mauro-hw/sky130-flash-adc-layout/(commit log)

2026-10-28 Start the SKY130 comparator layout project
    The comparator of the 3-bit flash ADC, as the pre-layout reference for LVS: every
    device is now a SKY130 device, with the 1.3 Mohm bias resistor as a high-resistivity
    poly resistor (0.35 x 227.5 um). Apache 2.0 with a NOTICE, so that reuse keeps the
    author's name.
2026-10-28 Credit the circuit to Claude and record its offset with mismatch
    The comparator was written by Claude in a development session, not designed by a
    VibeSPICE agent, so the README and NOTICE now say so. With the PDK's mismatch models
    (tt_mm, 30 runs) its offset has a 22.8 mV standard deviation against a +-8.16 mV
    requirement: the input pair and the mirror are too small, which the layout cannot fix.
2026-10-29 The comparator to lay out, verified before layout
    A VibeSPICE session (Claude Code as its agent) redesigned the comparator for a
    random offset of at most 8 mV, which the ADC's yield asks for. A review then
    found that its mismatch was overstated (m= without mult=) and that its
    regular-Vt pair left the tail source without headroom at the top tap, so the
    pair became low-Vt: sigma 5.2 mV over 112 copies in three corners, and 1.87 uA
    in the tail at 0.79 V in ss.
    scripts/sim.py measures the offset with mismatch, the offset at each tap, the
    current and the output levels; it will run the extracted netlist too. The
    README tells how the design got here and the layout plan.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
2026-10-29 The physical verification flow: DRC, LVS, extraction and GDS
    scripts/flow.py runs Magic without a window for DRC, the extraction (for LVS, and
    flat with parasitic capacitances for simulation) and the GDS, and Netgen for LVS;
    its self-test checks the tools on a transistor from the PDK's generator. sim.py
    now wires the comparator by pin name, so it can run an extracted netlist whose
    pins come in another order.
    mag/.magicrc carries a fix for Fedora 44, whose Magic runs on Tcl 9: the PDK's
    device generators read $sky130::ruleset from inside the namespace sky130, which
    Tcl 9 no longer resolves, and every generated device failed.
2026-10-29 Flow: LVS and the extracted netlist work; the mirror exercise
    With Netgen 1.5 the self-test now passes end to end: no DRC errors, LVS matches
    uniquely, and the extracted transistor draws the same current in ngspice as the
    schematic's (24.46 uA). The flat extraction needed "ext2spice subcircuit top on"
    to keep its .subckt.
    netlist/mirror.spice is the reference for the first layout exercise, the
    comparator's NMOS mirror in a row D A B B A D with its dummies; Netgen matches a
    row of separate units against it.
2026-10-29 Magic on Tcl 9: fix the device dialog too
    Devices 1 -> nmos failed with "can't set magic::w_val: parent namespace doesn't
    exist": Magic's toolkit.tcl sets magic::${pname}_val from inside the namespace
    magic, which Tcl 9 reads as ::magic::magic::w_val, while the dialog's fields use
    ::magic::w_val. .magicrc now redefines the seven procedures that do it with the
    absolute name, which means the same in Tcl 8 and 9.
2026-10-29 Mirror exercise: one 6-finger device, D B A A B D
    Placing six separate units with their guard rings is a fight with Magic's mouse
    for a first layout. The exercise is now one 6-finger device from the generator,
    with its guard ring, whose diffusion strips are routed to their nets. With
    shared diffusion a dummy touches a signal net, so the order is D B A A B D: the
    dummies share the diode's node, in, of low impedance, rather than out. Netgen
    matches that routing against this reference.
2026-10-29 flow.py: the LVS reference as an absolute path
    Netgen runs in the build folder, so a relative reference netlist was not found.
2026-10-29 Mirror: the first layout, DRC and LVS clean
    The comparator's NMOS mirror load as one 6-finger low-Vt device in the order
    D B A A B D, routed in Magic: the vss strips down in metal2 to a bus under the
    guard ring, the gates G1-G4 joined by a metal1 bar with the diode's columns
    brought to it in metal2, and out up the middle column. No DRC errors, and LVS
    matches netlist/mirror.spice uniquely.
2026-10-30 Input pair: a 2 x 4 common centroid, DRC and LVS clean
    The comparator's PMOS input pair as one low-Vt device of two rows of six
    fingers in one n-well with its guard ring, top row D A B B A D and bottom
    row D B A A B D. Columns and gates rise or fall in metal2 to metal1 buses
    above and below the array; TAIL crosses it at the columns it has in both
    rows, and the other four nets cross over the dummies, so no metal passes
    over a real finger's channel. Each drain carries two dummies. No DRC
    errors, and LVS matches netlist/pair.spice uniquely.
    The diary gains how to read a layout and the pair, and a trap: Magic's
    writeall force rewrote an unexpanded transistor at half its resolution.
    Co-Authored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
2026-10-30 Diary: how the comparator decides
    The chain from the inputs to out, block by block; why each stage acts
    like an inverter rather than a divider, with the gain measured in tt;
    and why XM6 does not need to turn off for out to rise.
2026-10-30 Second stage: XM6 as one 2-finger device, DRC and LVS clean
    XM6's errors reach the input divided by the first stage's gain, so it
    gets no common centroid and no dummies: two fingers of the mirror's unit
    in a guard ring, with out on the shared middle column (half the junction
    of two outer ones). OUT1 enters on a metal1 bar over the top gate
    contacts and out leaves downwards in metal2, on the opposite side. No DRC
    errors, and LVS matches netlist/stage2.spice uniquely.
    pair.mag only lost its timestamp and Magic's pending-DRC note when it was
    saved again.
2026-10-30 Bias mirror: one row D 8 5 5 7 7 5 5 8 D, DRC and LVS clean
    The PMOS bias mirror (XM8, XM5, XM7) as one low-Vt device of ten fingers
    in a guard ring. Its errors change the currents by a few per cent but
    hardly the offset, so it needs no more than a symmetric row. With shared
    diffusion only two symmetric orders work; this one gives out a single
    shared column and lets the dummies touch VBIAS, a DC node. VBIAS and vdd
    leave on top, TAIL and out at the bottom. No DRC errors, and LVS matches
    netlist/bias.spice uniquely.
    stage2.mag and its transistor only lost their timestamps and Magic's
    pending-DRC notes when they were saved again.
2026-10-30 Bias resistor: four strips as a serpentine, DRC and LVS clean
    The bias resistor as four high-resistivity poly strips joined in esses in
    metal1, so every link is short and both ends leave on the same side. Its
    value sets the currents but not the offset, so it has no dummies. No DRC
    errors, and LVS matches netlist/rbias.spice uniquely.
    The README's layout plan becomes the layout as drawn, block by block, and
    no longer says the diary records who found each problem.
    bias.mag and its transistor only lost their timestamps and Magic's
    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
2026-10-30 Top cell: the comparator laid out, DRC and LVS clean, simulated after layout
    The five blocks in one cell of about 34 x 61 um: the bias mirror and the
    second stage side by side on top, so out stays short and away from the
    inputs; the pair below them and the mirror at the bottom; the resistor on
    the left, upside down, so VBIAS goes straight to it. No DRC errors, and LVS
    matches netlist/comparator.spice, which now lists the layout's eight
    dummies, switched off.
    sim.py measures the delay too, the only row the layout's capacitances can
    change. After layout the DC rows are identical and the offset's sigma stays
    within the noise of its estimate; the delay at 10 mV overdrive grows by 22
    to 41 %, mo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
2026-10-30 Reference ladder: 16 strips as a serpentine, DRC and LVS clean
    The ADC's reference ladder from VibeSPICE: 16 high-resistivity poly
    strips, two per step, joined as a serpentine so that vss, the seven taps
    and top all leave on one edge, with a dummy strip at each end tied to vss.
    For 3 bits its matching hardly matters (200 ladders with the PDK's
    mismatch: at worst 0.011 LSB of DNL and 0.018 LSB of INL), so it is one
    compact block. No DRC errors, and LVS matches netlist/ladder.spice.
    comparator.mag, rbias.mag and its resistor only lost their timestamps and
    Magic's pending-DRC notes when they were saved again.
2026-10-31 Encoder: 11 gates drawn like standard cells, DRC and LVS clean
    The ADC's encoder from VibeSPICE (thermometer to 3 bits) as three gate
    cells, an inverter, a NAND2 and a NAND4, each a PMOS over an NMOS whose
    rings give the vdd and vss rails, and a row of the 11 gates in the order
    N12 I2 N24 N34 I4 Nb0 Ib2 N56 I6 Nb1 I7, so that t1 to t7 arrive in order.
    The nets between gates run on 4 tracks under the row. The parallel PMOS
    of each NAND share the output column. The rings are generated with 80 %
    contact coverage, so two neighbours' contacts keep their spacing. No DRC
    errors, LVS matches each reference, and the extracted encoder gives the
    8 codes right in tt, ss and ff.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
2026-10-31 Comparator: the bias resistor folded into ten strips, 47 % less area
    The bias resistor's 4 segments of 55 um set the comparator's height, so
    half of its 34 x 61 um was empty. Drawn as ten strips of 22 um in series
    the resistor is as tall as the rest, and the comparator is 39.0 x 28.4 um.
    Netgen adds the lengths of resistors in series, so the netlist stays as
    designed; the extra contacts add 0.3 % to the value. The resistor goes in
    rotated so that its VBIAS end is next to the bias mirror. No DRC errors,
    LVS matches, and after layout the delays and the DC rows are unchanged.
2026-10-31 The whole ADC: seven comparators, ladder and encoder, DRC and LVS clean
    The 3-bit flash ADC laid out: the comparators in one column, the ladder
    beside it as a column of 8 steps (each the netlist's two strips of 47 um
    drawn as four of 23.5 um, both ends facing the comparators), so that each
    tap meets its comparator's inn, and the encoder on the other side. All the
    wiring is metal1 and metal2: each comparator's inn, inp, output and vdd
    buses extend out of it onto spines. No DRC errors, and LVS matches
    netlist/adc.spice, which includes the blocks' netlists.
    scripts/adc_sim.py sweeps the ADC's transfer curve in the three corners:
    before and after layout, no missing codes and the 7 thresholds in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
2026-10-31 Images of the ADC and the comparator, and the script that draws them
    scripts/render.py reads the .mag files, applies each subcell's transform
    and draws every layer in its colour, with labels on the blocks, a legend
    and a scale bar; Magic's own plot draws only some layers without a
    display. The README shows the whole ADC at the top and the comparator in
    its layout section.
2026-11-02 Rename the project sky130-flash-adc-layout, before publishing it
    The repository now holds the whole ADC, not only its comparator. The
    netlists keep crediting VibeSPICE without the names of its internal
    projects, and the README says the layout makes the comparator 22 to 41 %
    slower, which its status line put the wrong way round. adc.mag and
    ladder.mag only lost their timestamps when they were saved again.
2026-11-02 A top-level schematic of the ADC, checked against its netlist
    xschem/adc.sch draws the ADC's top level: the 16-resistor ladder, the seven
    comparators and the encoder, with symbols for the comparator and the
    encoder. flow.py's new step 'sch' netlists it with xschem and compares it
    with netlist/adc.spice in Netgen: they match uniquely. The README shows
    it in the circuit section. A plain copy of the PDK's resistor symbol keeps
    the picture clean, since xschem 3.1 prints its value as '?' without a
    window and cannot hide it.
    [adc.sch]
